Kaldek/EC5-fuel-calibrator/(commit log)

2023-11-09 Created basic code version that includes corrections for variations in supply voltage
    To cater for any fluctuations in the supply voltage (also used to feed the AVCC pin on the ATMega328), we get funky with the ADC registers so that we can deal with any issues with the voltage regulator putting out a clean 5v.
    Essentially this compares the ADC reading of the known stable 1.1v internal ATmega328 reference against what the voltage is at the AVcc pin. This gives us a correction factor created in the readVcc function. We can then correct the signal returned from the fuel tank rheostats (as and when they are affected by a variation in the voltage being sent to the rheostats).
2023-11-09 Create a data collection sketch
    The calibration tables provided in the simple sketch are now three years old and are not adequate for our goals of accuracy. This data collection sketch allows us to slowly fill the tank or drain the tank and take measurements by pressing a button connected to the Arduino.
    The goal is to be able to build a matrix of behaviour of all three rheostats and the low fuel switch, and use this to create a highly accurate table for driving the fuel gauge.
2023-11-10 Updated the rheostat printed output to use the accurate Vcc rather than assumed 5.0 volts.
2024-01-02 Remove LowFuelRheostat
    Removed all references to the Low Fuel Rheostat as this device is NOT a rheostat but rather a simple NTC resistor which heats up in the absence of fuel and stays cool in the presence of fuel.
    It is not useful to the calibration and will be moved out of circuit for the entire fuel measuring system and low fuel warning light.
2024-01-02 Added resistance calculation for rheostats
    During investigation of the fuel tank assembly, we learned much about the likely behaviour of each rheostat. As a result we believe it is important that the resistance of the rheostat is shown during data collection.
2024-01-03 Changed Input button to INPUT_PULLUP
2024-01-03 Fixed logic for Low Fuel Switch detection state
    [Data-Collection.ino]
2024-01-03 Change default state of button to HIGH
    Keep button high so the Arduino does not think button is pressed after reboot.
    [Data-Collection.ino]
2024-01-03 Major changes to fix fundamental bugs
    [Data-Collection.ino]
2024-01-04 Added note that VREF is only suitable for ATMega328 based devices.
2024-01-05 Create Calibration tester
    Validation of data collected via data collection Sketch.
2024-01-05 Added note that prototype circuits shown here used a classic Arduino
2024-01-05 Relocated description of low fuel light circuit
2024-01-08 Fuel gauge needle position tuning
    Existing PWM values between F and 3/4 updated.
2024-01-09 Add schematic
2024-09-25 Create AveragedCalibration.ino
    New version of base code. Averages fuel readings over 20 seconds before updating the gauge and light control. Removes use of delay() so that the loop always runs and is driven based on counting of milliseconds and allowing for concurrent operation of the low fuel level light control and fuel level readings.
2024-12-10 Create EMA-calibration.ino
    New code using Exponential Moving Average to further slow things down.
2024-12-20 Major update to calibration
    Re-calibrated sender readings using in-car installation. Remove light flashing for low fuel and restricted low fuel light to when left-side low fuel switch is closed.
2024-12-22 FIxed Low Fuel light stuck on, tweaked gauge needle position
    Based on empirical driving, the gauge needle position at "Full" needed to be brought down a small amount, and around & just above 1/4 tank, needed to be brought up a little.
    Low Fuel Light logic was also missing the default of "Off" so it was getting stuck on once it triggered once.
    [EMA-calibration.ino]
